alexew0923/Air_Quality_Monitor/Assets/Air_Quality_Monitor.jpeg

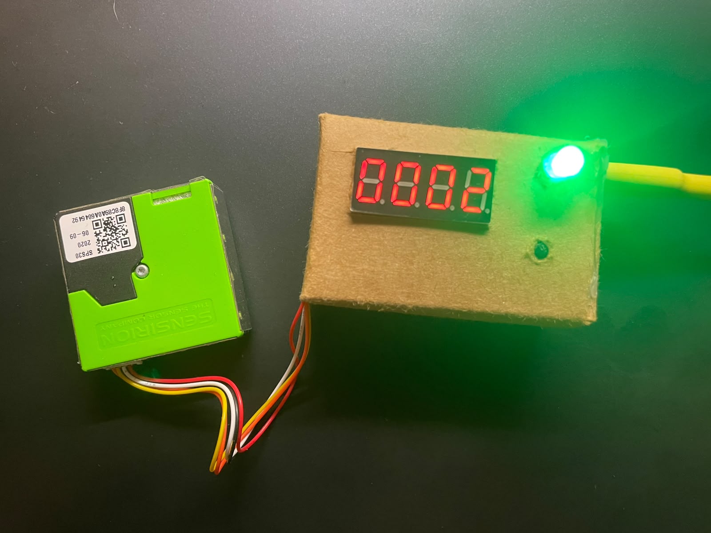
Assets/Air_Quality_Monitor.jpeg
