alexew0923/Air_Quality_Monitor/Autodesk_Fusion/AQM_Case.step

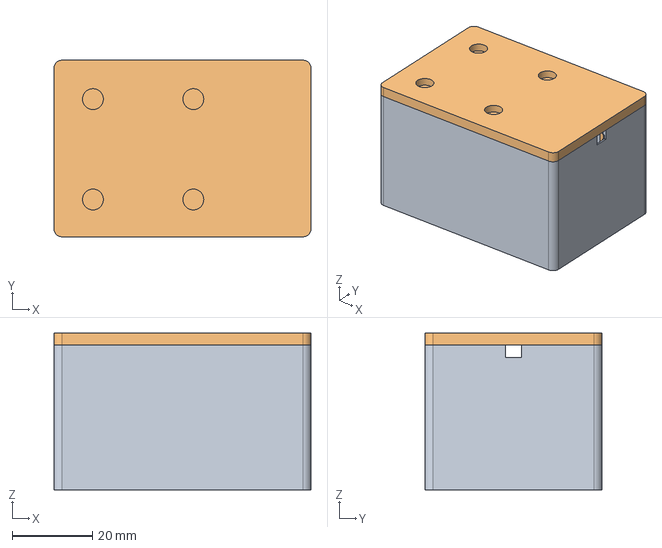
[picture p5: CAD file, 2026-11-05]
Autodesk_Fusion/AQM_Case.step
64.0 x 44.0 x 39.0 mm
Lid
