alexew0923/Air_Quality_Monitor/(list of files, cad)

Other CAD files:
Autodesk_Fusion/AQM_Case.f3d
Autodesk_Fusion/AQM_Case.stl
